hiperionn04/ubiGuard/(commit log)

2026-04-27 magnet + PIR
2026-05-04 pin update
2026-05-08 Added Change Pin to APP Added set PIN & Change Pin in Arduino
2026-05-11 Disarm/Arm on app
2026-05-16 Add camera HTML with Firebase integration
2026-05-16 Add camera menu string to strings.xml
2026-05-16 Add camera menu option to strings.xml
2026-05-16 Add TextView for camera menu option
2026-05-16 Add camera menu option and click listener
2026-05-26 Update WebView URL for camera viewer
2026-05-26 Refactor stream request handling in camera.html
    Refactor stream handling logic to improve clarity and control.
2026-05-29 Camera on Alarm Windows.
